DrRoot-github/bimimi-5024/README.md

# bimimi-5024

## 概要

ビット・トレード・ワン社のバイノーラルマイク「美耳」をベースにしたバイノーラルマイク。\
美耳 https://github.com/bit-trade-one/ADBMM

詳細は以下
https://drroot.page/wp/?p=355
