DrRoot-github/bimimi-5024/schematics/README.md

～.kicad\_ファイル 4 つを同じディレクトリに置いて kicad で\_pcb ファイル開くと設計データ開ける
