DrRoot-github/bimimi-5024/models/README.md

# 3d models

Prusa Slicer で 3mf を開けばスライスの設定も移行できる。
本体と蓋は PLA、耳型は TPU で作る。
プリンタやスライサーは人によると思うので、制作時の設定を下記にざっくり書く。

## 本体(main)と蓋(futa)

| 設定値 | Prusa Slicer での項目名 | パラメータ |
| --- | --- | --- |
| 積層ピッチ | 積層ピッチ | 0.2mm |
| 垂直境界のレイヤー数 | 境界線 | 本体 2 蓋 3 |
| 水平境界のレイヤー数 | ソリッドレイヤー | トップ/ボトム 3 |
| インフィル密度 | 充填密度 | 7% |
| インフィルパターン | | ジャイロイド |
| ブリムタイプ | | 外側のブリムのみ |
| ブリム幅 | | 8mm |
| ブリム分離ギャップ | | 0.5mm |
| オーバーハングのしきい値 | | 45° |
| サポートのスタイル | スタイル | スナッグ |
| サポート材のコンタクト距離 | トップ/ボトムコンタクト Z 距離 | 0.3mm |
| XY 麺でのサポートとモデルの隙間 | | 100% |
| ブリッジ部分のサポート禁止 | | 有効 |
| エレファントフットの補正 | 最初の層の広がり補正 | 0.2mm |
| ノズル温度 | | 1st レイヤー 220℃、以後 205℃ |
| ベッド温度 | | 1st レイヤー 70℃、以後 65℃ |
| 境界線 | | 180mm/s |
| 最初のレイヤーの速度 | | 60mm/s |

## 耳型(ear_panel_l)

※右耳側はスライサー上で左右反転して Gcode を生成する\
※高さモディファイアを使用し、最初の 2.5mm はソリッドレイヤーを 3 層・インフィル率を 10 ～ 15%に設定する

| 設定値 | Prusa Slicer での項目名 | パラメータ |
| --- | --- | --- |
| 積層ピッチ | 積層ピッチ | 0.15mm |
| 垂直境界のレイヤー数 | 境界線 | 1 |
| 水平境界のレイヤー数 | ソリッドレイヤー | トップ 1/ボトム 2 |
| インフィル密度 | 充填密度 | 5% |
| インフィルパターン | | ジャイロイド |
| ブリムタイプ | | 無し |
| オーバーハングのしきい値 | | 45° |
| サポートのスタイル | スタイル | スナッグ |
| サポート材のコンタクト距離 | トップ/ボトムコンタクト Z 距離 | 0.3mm |
| XY 麺でのサポートとモデルの隙間 | | 110% |
| ブリッジ部分のサポート禁止 | | 有効 |
| エレファントフットの補正 | 最初の層の広がり補正 | 0.2mm |
| ノズル温度 | | 1st レイヤー 220℃、以後 210℃ |
| ベッド温度 | | 1st レイヤー 70℃、以後 65℃ |
| 境界線の速度 | 境界線 | 40mm/s |
| 短い境界線 | | 50% |
| インフィル | | 60mm/s |
| ブリッジ | | 20mm/s |
