DrRoot-github/bimimi-5024/schematics/bimimi5024sc.jpg

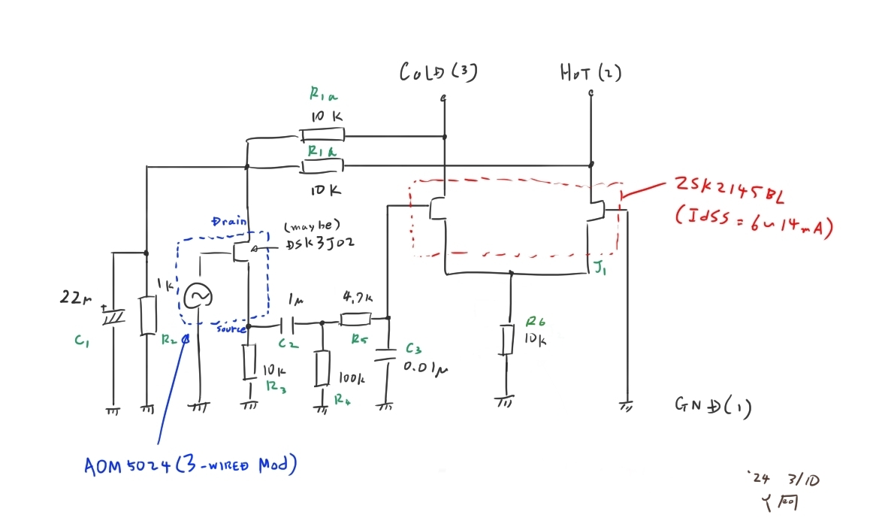
schematics/bimimi5024sc.jpg
