DrRoot-github/bimimi-5024/models/main.3mf

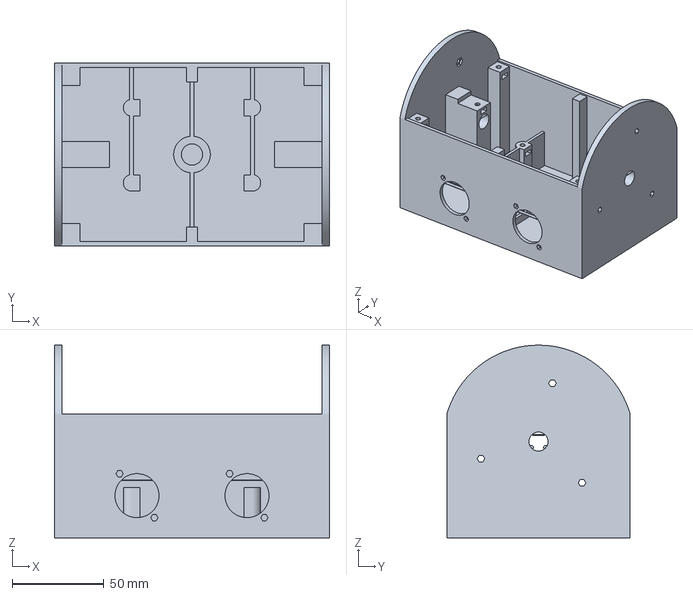
[picture p2: CAD file, 2024-04-17]
models/main.3mf
150.0 x 100.0 x 105.1 mm
