DrRoot-github/bimimi-5024/models/ear_panel_l.3mf

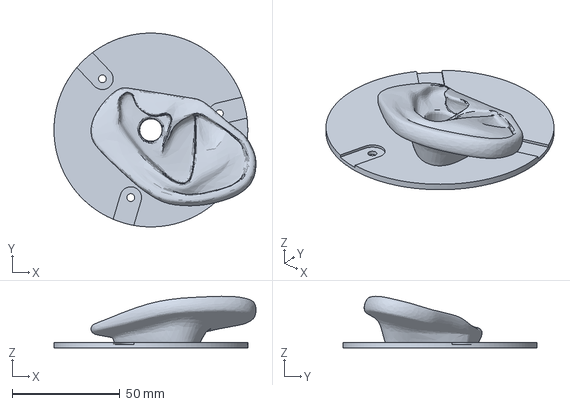
[picture p3: CAD file, 2024-04-17]
models/ear_panel_l.3mf
93.8 x 90.0 x 23.9 mm
