DrRoot-github/bimimi-5024/models/futa.3mf

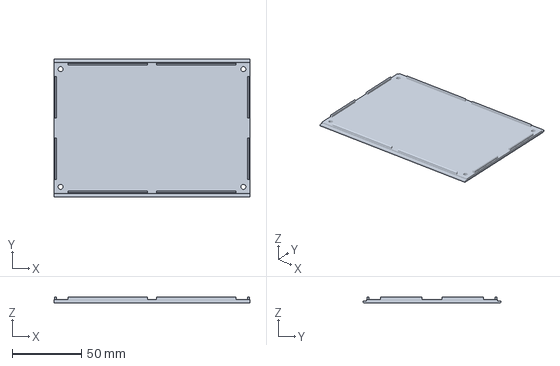
[picture p4: CAD file, 2024-04-17]
models/futa.3mf
141.5 x 99.6 x 4.50 mm
