DrRoot-github/bimimi-5024/(list of files, cad)

Other CAD files:
models/ear_panel_l.stl
models/futa.stl
models/main.stl
