DrRoot-github/bimimi-5024/schematics/bimimi5024.kicad_sch

## KiCad design schematics/bimimi5024.kicad_sch (2024-04-17)

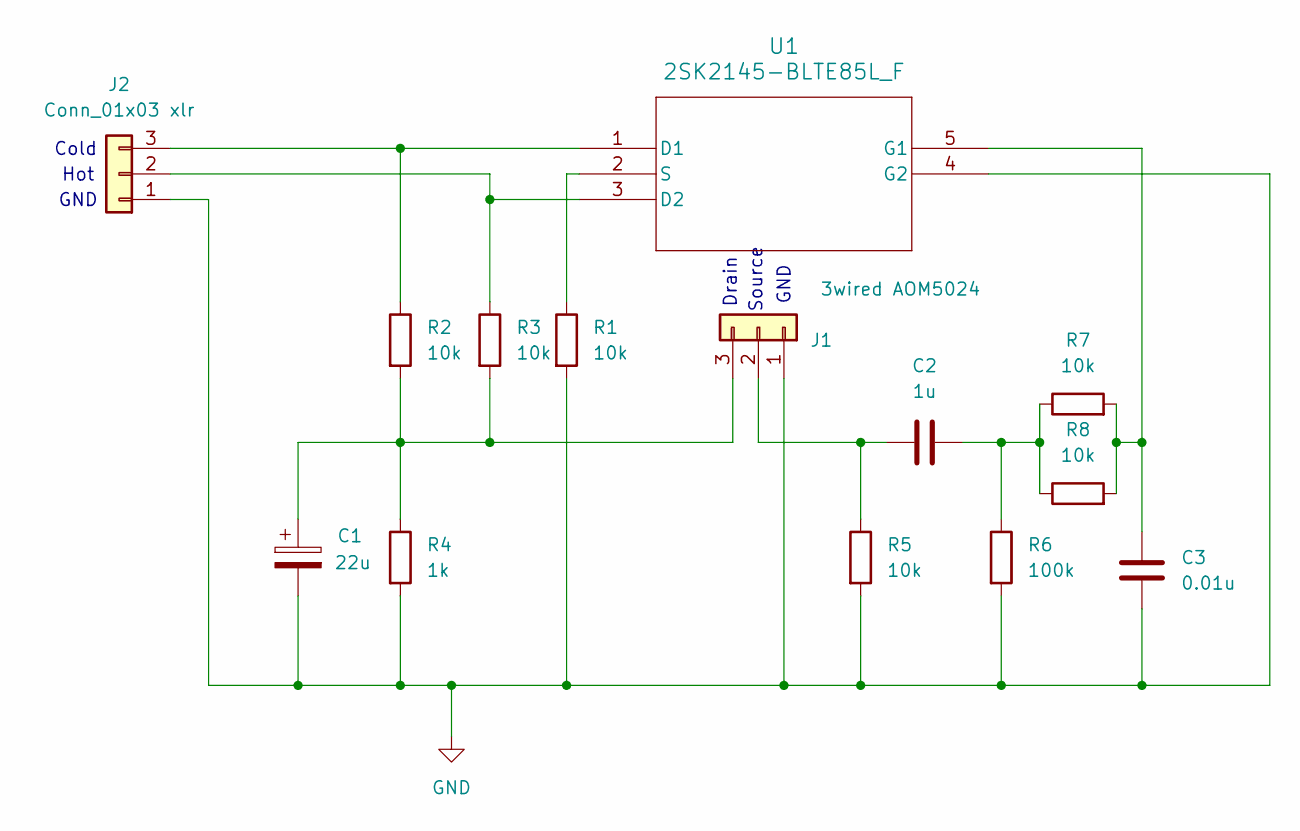
[picture p5: schematic bimimi5024.kicad_sch]

Parts:
C1: 22u; CP_Radial_D6.3mm_P2.50mm
C2: 1u; C_Rect_L7.2mm_W7.2mm_P5.00mm_FKS2_FKP2_MKS2_MKP2
C3: 0.01u; C_Rect_L7.2mm_W7.2mm_P5.00mm_FKS2_FKP2_MKS2_MKP2
J1: 3wired AOM5024; JST_VH_B3P-VH-B_1x03_P3.96mm_Vertical
J2: Conn_01x03 xlr; JST_XH_B3B-XH-A_1x03_P2.50mm_Vertical
R1, R2, R3, R5, R7, R8: 10k; R_Axial_DIN0204_L3.6mm_D1.6mm_P5.08mm_Horizontal
R4: 1k; R_Axial_DIN0204_L3.6mm_D1.6mm_P5.08mm_Horizontal
R6: 100k; R_Axial_DIN0204_L3.6mm_D1.6mm_P5.08mm_Horizontal
U1: 2SK2145-BLTE85L_F; SOT_BLTE85L_F_TOS

Connections:
GND: C1.2, C3.1, J1.1, J2.1, R1.2, R4.2, R5.2, R6.2, U1.4 (G2)
unnamed: C1.1, J1.3, R2.2, R3.2, R4.1
unnamed: C2.1, J1.2, R5.1
unnamed: C2.2, R6.1, R7.1, R8.1
unnamed: C3.2, R7.2, R8.2, U1.5 (G1)
unnamed: J2.2, R3.1, U1.3 (D2)
unnamed: J2.3, R2.1, U1.1 (D1)
unnamed: R1.1, U1.2 (S)

Notes on the sheet:
Source
Hot
GND
Cold
Drain
